freitz85/AppleIISd/Datasheets/AppleII_Timing.png

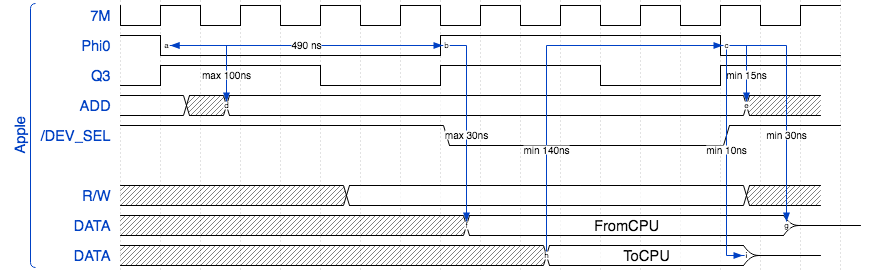
Datasheets/AppleII_Timing.png
