freitz85/AppleIISd/Datasheets/EEPROM_Timing.png

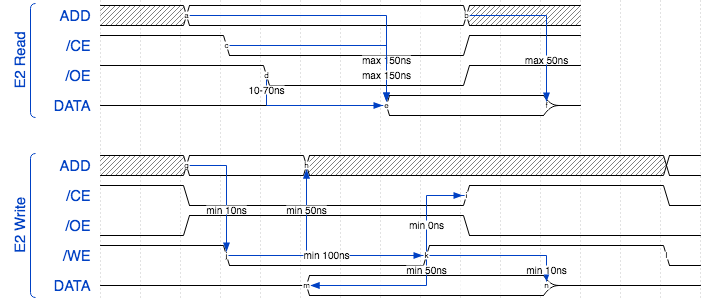
Datasheets/EEPROM_Timing.png
