freitz85/AppleIISd/Datasheets/plcc44_bottom.jpg

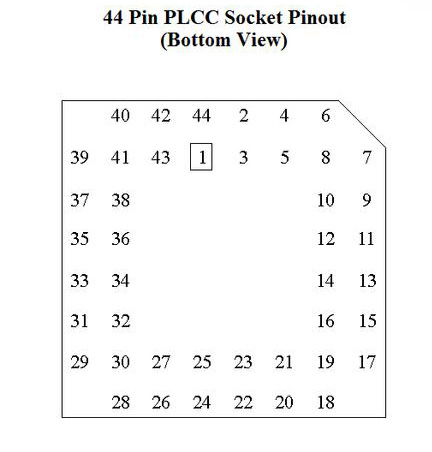
Datasheets/plcc44_bottom.jpg
