freitz85/AppleIISd/Images/Bus1.gif

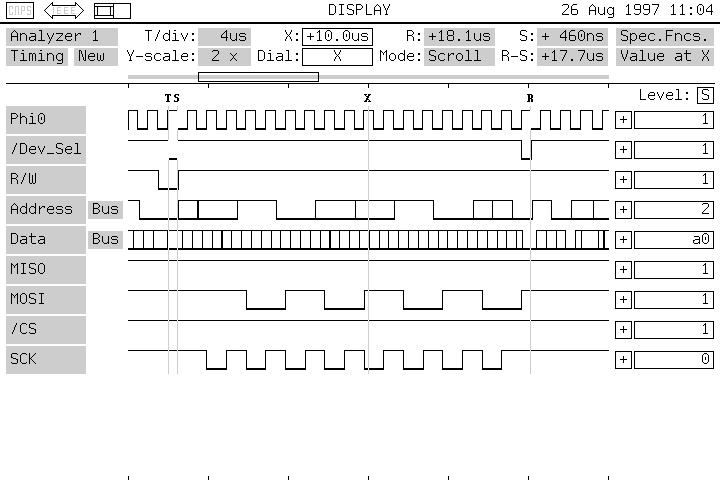
Images/Bus1.gif
