freitz85/AppleIISd/Images/Bus2.gif

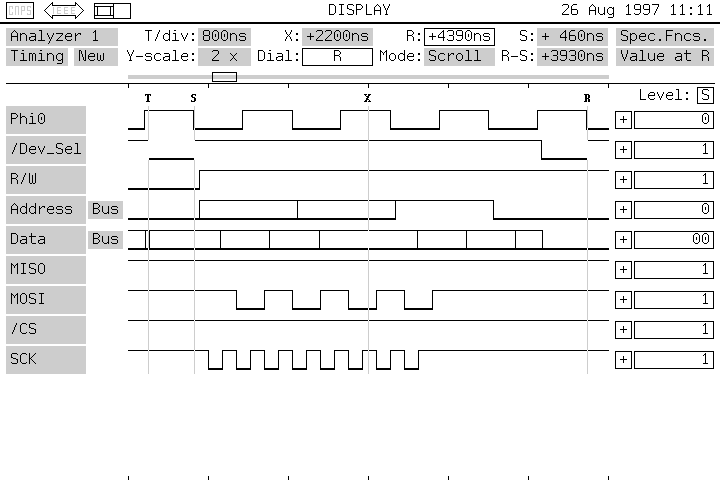
Images/Bus2.gif
