freitz85/AppleIISd/Images/Spi1.png

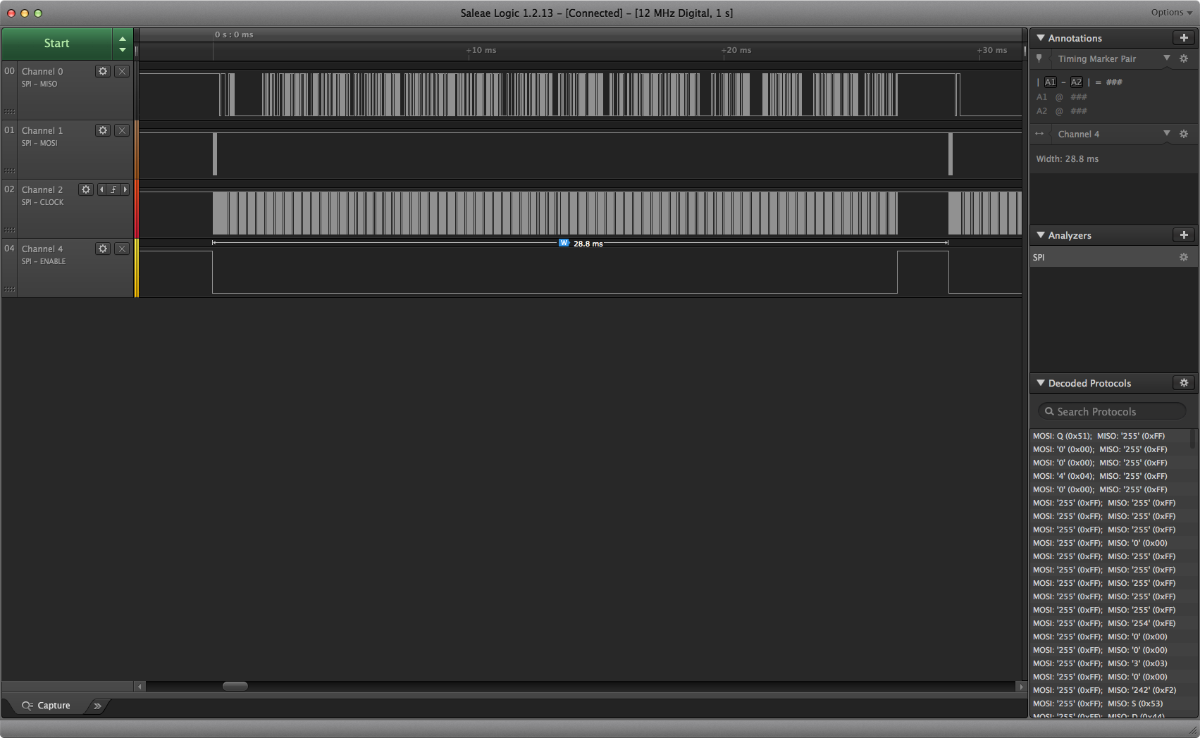
Images/Spi1.png
