freitz85/AppleIISd/Images/Spi2.png

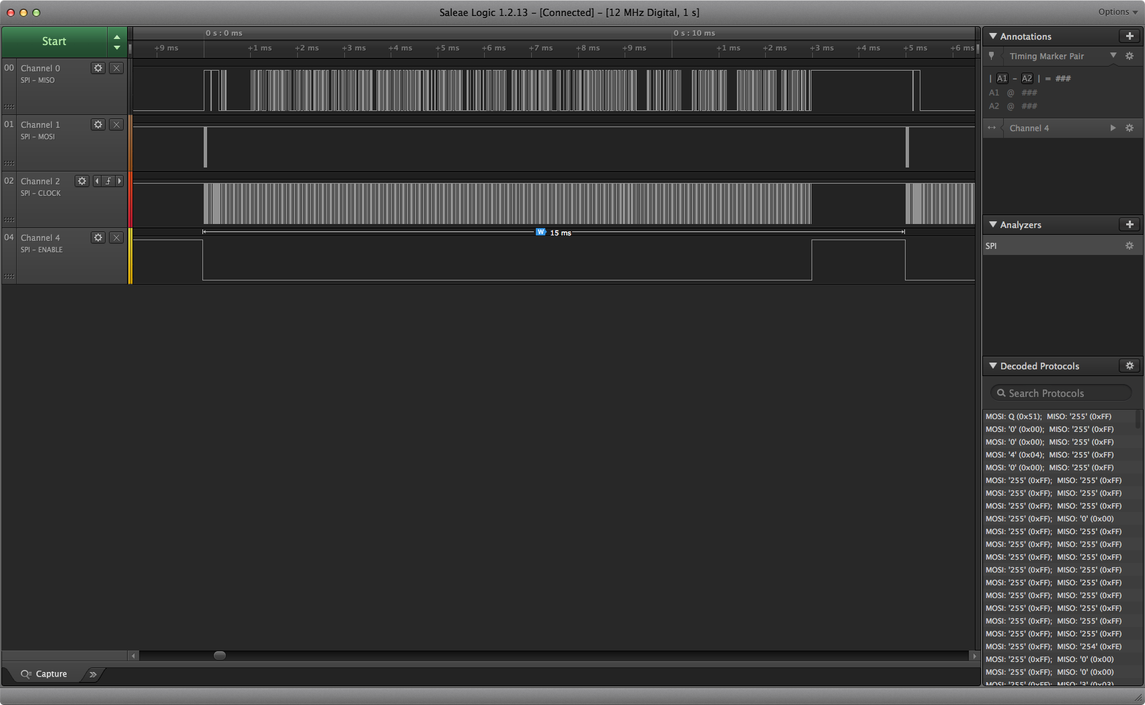
Images/Spi2.png
