freitz85/AppleIISd/Images/AddessDecoder_Test.JPG

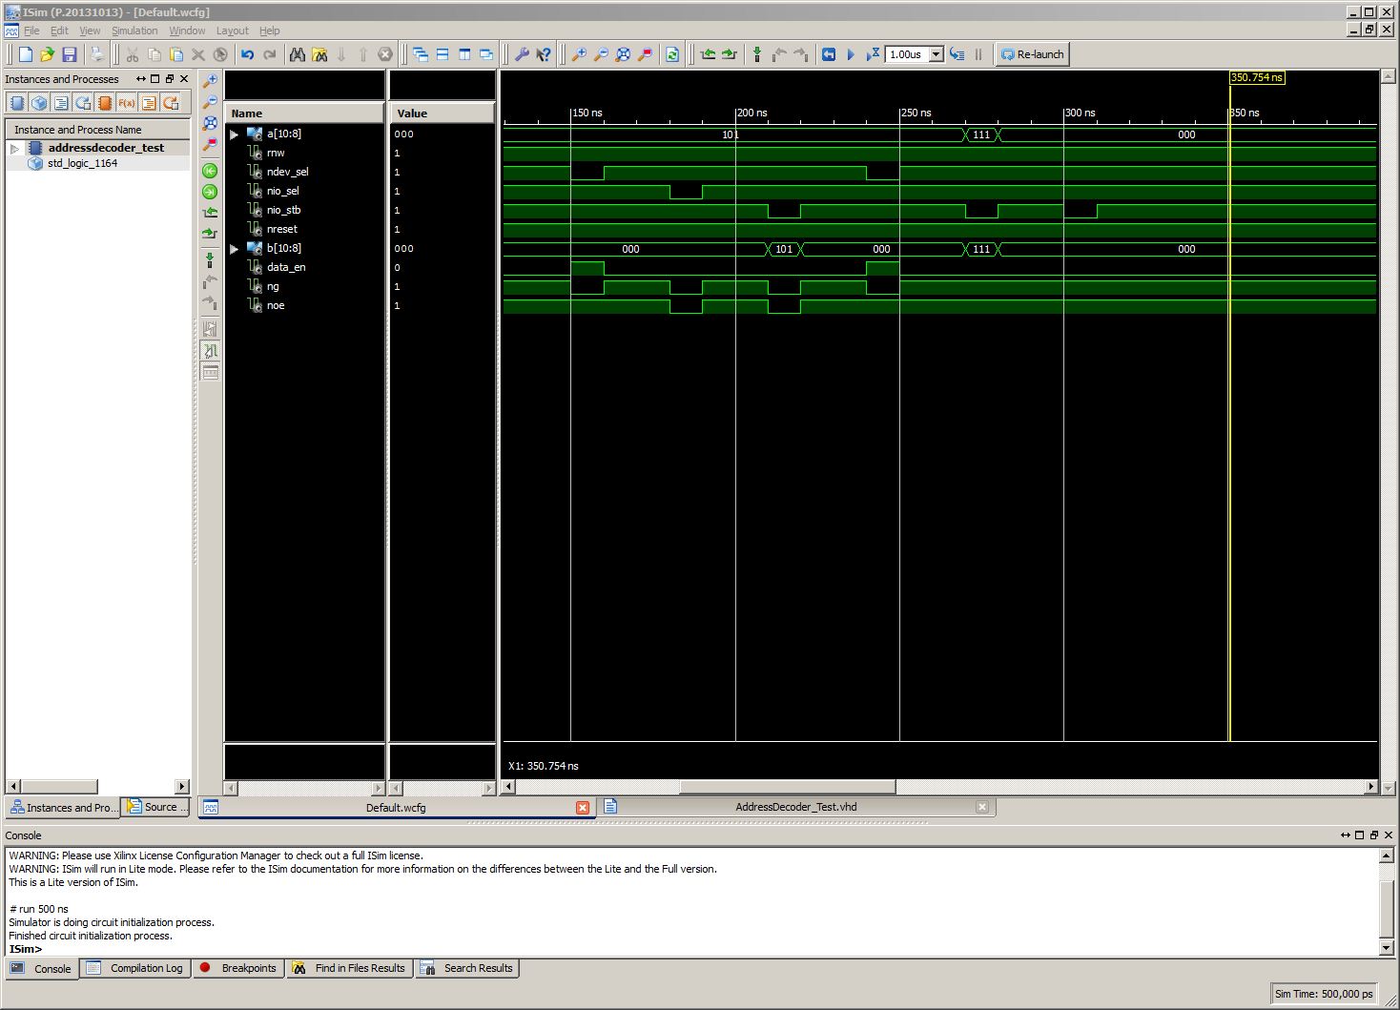
Images/AddessDecoder_Test.JPG
