freitz85/AppleIISd/Images/AppleIISd_Test.JPG

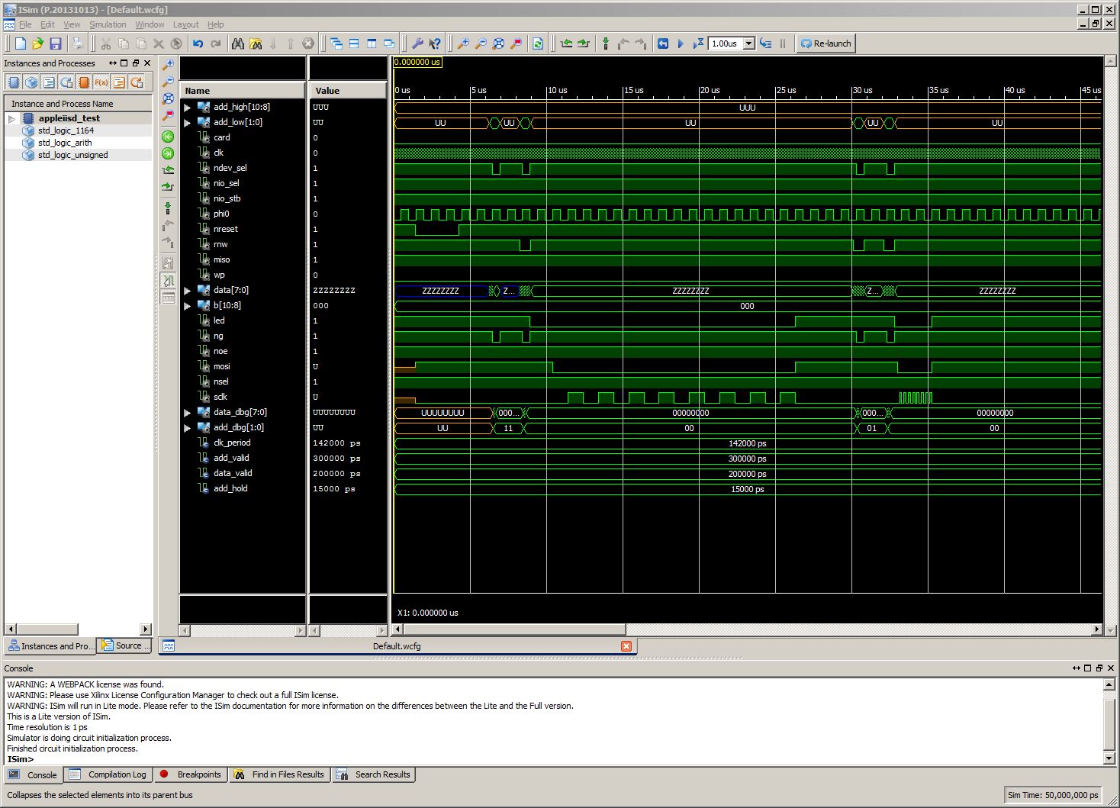
Images/AppleIISd_Test.JPG
