freitz85/AppleIISd/(threads)

Thread 1 (2018-10-10):

Waiting for card ready

vldmrrr, 2018-10-10:
Hello,

I made a card following your design on a prototype board. My card was having multiple problems when with initializing and reading cards so I was never able to boot prodos completely on my ROM 1 gs.

After some debugging I found that data send some time gets garbled by starting new transfer when previous one has not completed yet.

Also conparing with FatFS code for SD SPI I found they are waiting for card to be ready before sending read command.

I added checking of transfer compete on each send, and waiting for card ready for every command (except the very first one on init). Maybe that is an overkill, but at least this made my card able to init both v.1 and v.2 SD cards, and boot and work with prodos more or less reliably. I still can not boot gs/os though.

Take a look at pull request, maybe you would like to merge some or all of the changes into your code.

Thanks

freitz85, 2020-08-12:
Issue is outdated as code has been changed multiple times

Closed 2020-08-12.

Thread 3 (2019-11-27):

Booting no longer works on an Apple IIe

bokowski, 2019-11-27:
Booting the example image from an SD card does not work when using the latest state from the master branch. I ordered PCBs using the current Gerber files, configured the CLPD and burnt an EPROM and couldn't get it to work in my Apple IIe. It did work after I decided to try burning the EPROM image from commit f199354 ("ProDOS image for testing added").
I'm happy now but thought it would be useful to report this problem to you.

freitz85, 2019-11-28:
Thank you for letting me know, I will look into it!
Between those two commits, the Smartport driver was added and since nothing has changed.
Just to make sure, are you using an enhanced IIe with a 65C02 CPU?

bokowski, 2019-11-28:
Yes, I have an enhanced IIe with the 65C02 CPU. By the way, I completely
forgot to thank you for publishing this project, great work!

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

rapiqui, 2020-08-11:
Hi,

I am experiencing the same behavior commented by @bokowski .
I do have an enhanced IIe with a WDC65C02 (W65C02S6TPG-14 with pin 8 and 36 connected as per WDC note) and CD, EF and Video ROMS enhanced.
When I do try to boot a ProDOS image copied to a 2Gb SD with CiderPress I always get prompted to the System Monitor:

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

freitz85, 2020-08-12:
@rapiqui I have just pushed a change in commit 758abfde4b54e888f47e320f820b1ec8bff0dc5f that fixed an issue that the firmware could overwrite itself. Are you able to build the firmware or do you need a binary image?

In the fixes branch, I am still working on problems in the smartport part of the driver. Pure ProDOS mode (2 partitions) seems to work better there.

rapiqui, 2020-08-12:
Hi @freitz85 .
First of all big THANKS for this amazing project ;)

You would make me things easier if you could upload as well the binary image so I could update de EPROM content with the programmer.

If it can be helpful: just to mention that I have tried to boot the SD on the the Apple IIe slots 7,6,2 and 1 with the same results.
Tried your ProFile.2mg image and the latest version of Total Replay (4.0 alpha 2) with the same SysMon address shown.
Tried too partitioning the SD with CiderPress selecting a single ProDisk partition and 4/6 partitions which made no difference at all.

freitz85, 2020-08-19:
@rapiqui On startup, after initializing the SD card, the ProDOS bootloader is loaded from the first two blocks on the card to address $800 and then is called by a jump to $801, so $803 is the second byte after the start of it. When you are in this error, could you please type `800.880` or `801L` and post the output. This should show if the bootsector has been loaded correctly from the card.

Does the AppleIISd work when booted from a floppy, i.e. can you access any files? If yes, the problem might be in a corrupted image.

Have you followed my [posting ](http://bluemeanie-retro.blogspot.com/2017/12/how-to-prepare-sd-cards-for-appleiisd.html) on how to prepare an SD card? Under certain circumstances, Ciderpress may create a partition that is not on the physical start of the card and the AppleIISd can't handle this.

rapiqui, 2020-08-19:
@freitz85 Thanks for checking it out.
Yes, I did follow your post regarding CiderPress usage to create an usable AppleIISD SD Card.
Eventually I even had to switch from a 16Gb SD to an old 2Gb and afterwards to a 8Gb as CiderPress stated that volumes larger than 8 Gb weren't supported.

I have took a picture of the requested memory dump.
Please, let me know if you need additional info.

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

Cheers

rapiqui, 2020-08-24:
Thanks @freitz85 I had my suspects on the tested SD cards format, and re-formatted them again using the "SD Card Formatter" v.5.0.1 from Tuxera, which is the recommended tool by the SD consortium, but had no luck at all. All the 3 SD cards tested (2 Gb non-HC or XC), 8 Gb SDHC and 16 Gb HC behave the same way.
I will keep my fingers crossed and hope you could find out the reason why this could be happening :)

In regards of the serial card, unfortunately I do not have one, but happy to help and try to find why. If I need one in order that I could provide you more useful information I can try to find one.

freitz85, 2021-08-25:
It admittedly took a very long time, but I managed to push some fixes in b13ed9077f54387077b36edc959048bec4b9f689. Please try if this fixed the booting issues as well as the problems with some SD cards.

timmcross, 2022-03-11:
I am also seeing unstable behavior on my enhanced, platinum Apple IIe (2 memory chips).  It seems to run fine on my IIgs but on the IIe, it takes a few reboots before the card will boot properly.  Other times, it breaks to the monitor.  I can get screencaps if you like.  I will also try it on my older enhanced IIe (8 memory chips).

freitz85, 2022-03-15:
I have had the feedback from some users that they had similar issues but the reason seemed to be with the 74LS245. After swapping it worked, specifically on an Apple II+ with the firmware from the 6502 branch. Older LS parts seem to work better than newer ones, for whatever reason.
Unfortunately I am not able to work on the project right now, but what could be done is to compare the VHDL simulation that is already present in the project with a sample of the card working in an actual computer using a logic analyzer. According to Apple's tech pubs, both a HCT and LS should work, but I have had troubles with HCT as well.

timmcross, 2022-03-19:
Ah, yes.  That seemed to be the issue.  I was using a chip labeled as a 74LS245 I got from Amazon and had issues.  I pulled a 74LS245 from another Apple II motherboard and that worked much better.  Perhaps my Amazon 245 is actually a 74HC245.  Thanks!

rittwage, 2022-08-30:
I have the opposite problem. Mine is not stable on a IIGS either...

I have a ROM1 GS with a 4M RAM card (although that part I don't believe matters- I've tried the Apple 1.5M card also) and the card is in Slot 7. When I boot GSOS from the SD card, usually some time late in the load process (not usually always the same place) I will hear a "bonk" (IIgs beep) and it will hang. I can reboot with the keyboard reset, and eventually it will boot fine and run stable, sometimes after a couple of tries. I've replace the SD card and this doesn't seem to matter.

Is there a small issue with the driver, or is it my IIgs?

I can order some other 74LS245 if that is thought to help...

Dirk-, 2022-08-30:
> I have a ROM1 GS with a 4M RAM card (although that part I don't believe matters- I've tried the Apple 1.5M card also) and the card is in Slot 7. When I boot GSOS from the SD card, usually some time late in the load process (not usually always the same place) I will hear a "bonk" (IIgs beep) and it will hang. I can reboot with the keyboard reset, and eventually it will boot fine and run stable, sometimes after a couple of tries. I've replace the SD card and this doesn't seem to matter.

@rittwage Very similar to my problem. I have a ROM03 GS and the card sometimes hangs during boot, sometimes when launching programs. It is not reliable.

My card came fully equipped from Jens Fischer (who handles the "[shop](http://bluemeanie-retro.blogspot.com/2020/04/prebuilt-appleiisd-v121-finally.html)" for @freitz85, I think). I updated the firmware to the latest version, but this didn't help. I wouldn't mind buying another 74LS245 if someone knew a reliable source.

rittwage, 2022-09-23:
 I tried a different brand (and older) 74LS245 as well as a newer 74HCT245. The behavior did not change, unfortunately.

Thread 4 (2021-03-11):

Flash does not work on IIGS ROM1 or ROM3 - always stuck at 4%

chuck424242, 2021-03-11:
I have two AppleIISD cards and wanted to update to 1.2.2 (currently I am on 1.2.1)
I tried the flasher, put the jumper to R/W (2-3). It will start to flash, but always gets stuck at 4%

Tried it on a ROM1 and ROM3 IIGS, in 1MHz and 2.8MHz speeds. Same results on both machines.

freitz85, 2021-03-15:
I have had the same issue on two boards but only on the IIe, the IIgs seemed more reliable.
You could try to erase the EEPROM first by specifying "0" as the slot in the flasher app.

chuck424242, 2021-03-15:
I have tried it, but the erase gets stuck at 1%. I tried again with flashing and it is still the same, stuck at 4%. I guess in the meanwhile I need to unsolder the 28F64 and programm it external. :(

chuck424242, 2021-03-22:
Found something interessting. It is wokring ONLY when a SD Card is inserted. If NO SD Card is in. Flashing will always fail.

freitz85, 2021-03-22:
This is indeed interesting, as the SD card should have no effect at all. The only connection between the part that accesses the SD card and the EEPROM is the write enable bit set in the CPLD registers. Apart from that all address translation for SLOTROM and the $C800 space is completely separate.

chuck424242, 2021-03-23:
Yes, this was surprising to me as well. I did have the SD Cards removed just to be sure there is no interference. I have test a couple of more times, and it is reproduceable, as soon as the SD card is in it always works. As soon as no SD card is in it fails at 1% for erase and 4% for flashing. I have just tested with the 1.2.2. not with 1.2.1 yet

freitz85, 2021-03-23:
Thank you for verifying this behaviour.
I will try to test this and review the VHDL code if some strange interaction has crept in.

If you like to, you could test it with the previous version of the flasher application to see if the behaviour stays the same.

Thread 6 (2022-01-07):

SPI ethernet extension

Sch-LikA, 2022-01-07:
Hello !

I recently came across your amazing project, what an amazing piece of open-source project, thanks for your time ! I will definitively build one when I get my IIgs. As I am also evaluating options to network it, and see that in a way that project is a kind of AppleII-to-spi adapter, would it be possible to implement some ethernet via for example a [WIZ5500 chip](https://www.mouser.ch/datasheet/2/443/Wiznet_W5500_DS_1%200%205-1212109.pdf) ?

Drivers would need to be written for the [Marinetti ip stack](http://www.apple2.org/marinetti/) but that card would become the ultimate card to own !!

Thanks again !

freitz85, 2022-01-10:
Hi,
thank you for your very interesting suggestion! You are right that this is basically an Apple-to-SPI adapter. I will look into the chip to see what is possible with the current design, as there are no I/O pins left on the CPLD.  But I am almost sure we will find a way to make it work.
However, it will take a few weeks as I am currently tied up in other things.

Sch-LikA, 2022-01-10:
Hi ! Thanks for the interest ! I came across a very interesting news : [ESP-WNIC](https://www.youtube.com/watch?v=2E6cgL-LB-I), basically you can use one of those super cheap ESP32 MCU as a Wifi interface (with or without tcp stack), interfaced through spi ... That would be a world premiere, a wifi interface for Apple II :-)

And for the i/o pins, if I understand SPI correctly, only one I/O should be needed, the "chip select" one, that could be either the sd or the ethernet, that could be NOT'ed on the ESP32 (it is a huge MCU in the end). Could one I/O pin be freed somehow (2 would maybe be easier) ?

Since the ESP32 also does Bluetooth, sky's the limit :-) ... keyboard, mouse, gamepad, ...

Thread 7 (2022-01-29):

Post to PCBWay Shared Projects?

dlxmax, 2022-01-29:
I'm glad I found the AppleIISD and your blog as well, as this is exactly what I need for my IIe! Thanks.
One thing, would you mind posting it to PCBWay Shared Projects? That way anyone can order just one board at a very low price. I really don't need ten! It could also help promote the project. More people should know about this.

I would post it myself, but they give a 10% kickback on PCB sales to the poster, which really should be you.
Again, thanks for this. I look forward to building it!
https://www.pcbway.com/project/shareproject/

freitz85, 2022-03-11:
Thank you for this suggestion, I will have a look into it. It sounds very interesting!

Closed 2022-07-11.

Thread 8 (2022-03-01):

Replacement for 28C64

timmcross, 2022-03-01:
Because these are so hard to find, I was thinking of using a 28C256.  I think it has the same pinout just 2 or 3 more address lines which I could pull high or low.

Also, I see the picture uses a -15 part.  Would a -25 part be too slow or is that fine for an IIe or IIgs?

Thanks!

freitz85, 2022-03-04:
Thank you @timmcross, for the suggestion!
I compared the two chips and it should be possible to use both when the the two additional address lines are tied to ground. I will include this in upcoming hardware revisions.
Meanwhile it is possible to use two jumper wire to ground, as the pins were not connected yet.

Regarding the speed I will have to do some more digging, but I assume a slower one could be fine.

timmcross, 2022-03-11:
I was able to ground out the extra address lines (A11 and A12 were already grounded, I added A13, A14 from the 28c256) and it seems to work fine.  I didn't try a -25 part however.  Thanks!

Closed 2022-03-11.

Thread 9 (2022-03-07):

CPLD programming

timmcross, 2022-03-07:
Sorry for an obvious question but after setting this project up from scratch, I think I am missing the part where the CPLD gets programmed.  I am having an issue with the flasher program (using a 28C256 but that is probably a different issue) but I assume that is only to flash the EEPROM?  I have been looking for the overall steps to set one of these up and I cannot find it.  Will flasher upload code to the EEPROM which will in turn flash the CPLD or does the CPLD need to be programmed separately?  Perhaps by a Raspberry PI and the included header on the board?  Thanks...

timmcross, 2022-03-10:
So I took some time to google XC9572XL programming with a Raspberry PI and found a procedure to program one with xc3sprog.  I used a RPI v1 I had sitting around and programmed the VQ44 jed file you have in the repository.  After that, "flasher" completed and I was able to boot the card!  Great work!  Total Replay booted right up.  Thanks for developing this product!

freitz85, 2022-03-11:
Sorry for answering late, I also wanted to suggest the RPi solution as I found the (knockoff-) Xilinx programers not to be very reliable.
I will add this information to the readme so that others can benefit from this. Thank you for bringing this to my attention.

Closed 2022-03-10.

Thread 12 (2023-11-19):

Six partition update?

dlxmax, 2023-11-19:
As ProDOS v2.5 supports 32 drives per slot (https://prodos8.com/releases/prodos-25/), would it be possible to modify the firmware so that we could get six partitions?

BTW, Great project. Thank you! I built two of these for my own use. One is on a partially-enhanced IIe (just 65C02). It doesn't auto-boot, but typing PR#5 adds to the nostalgia.
