freitz85/AppleIISd/Binary/AppleIISd.pdf

## 470⁺³V³

1

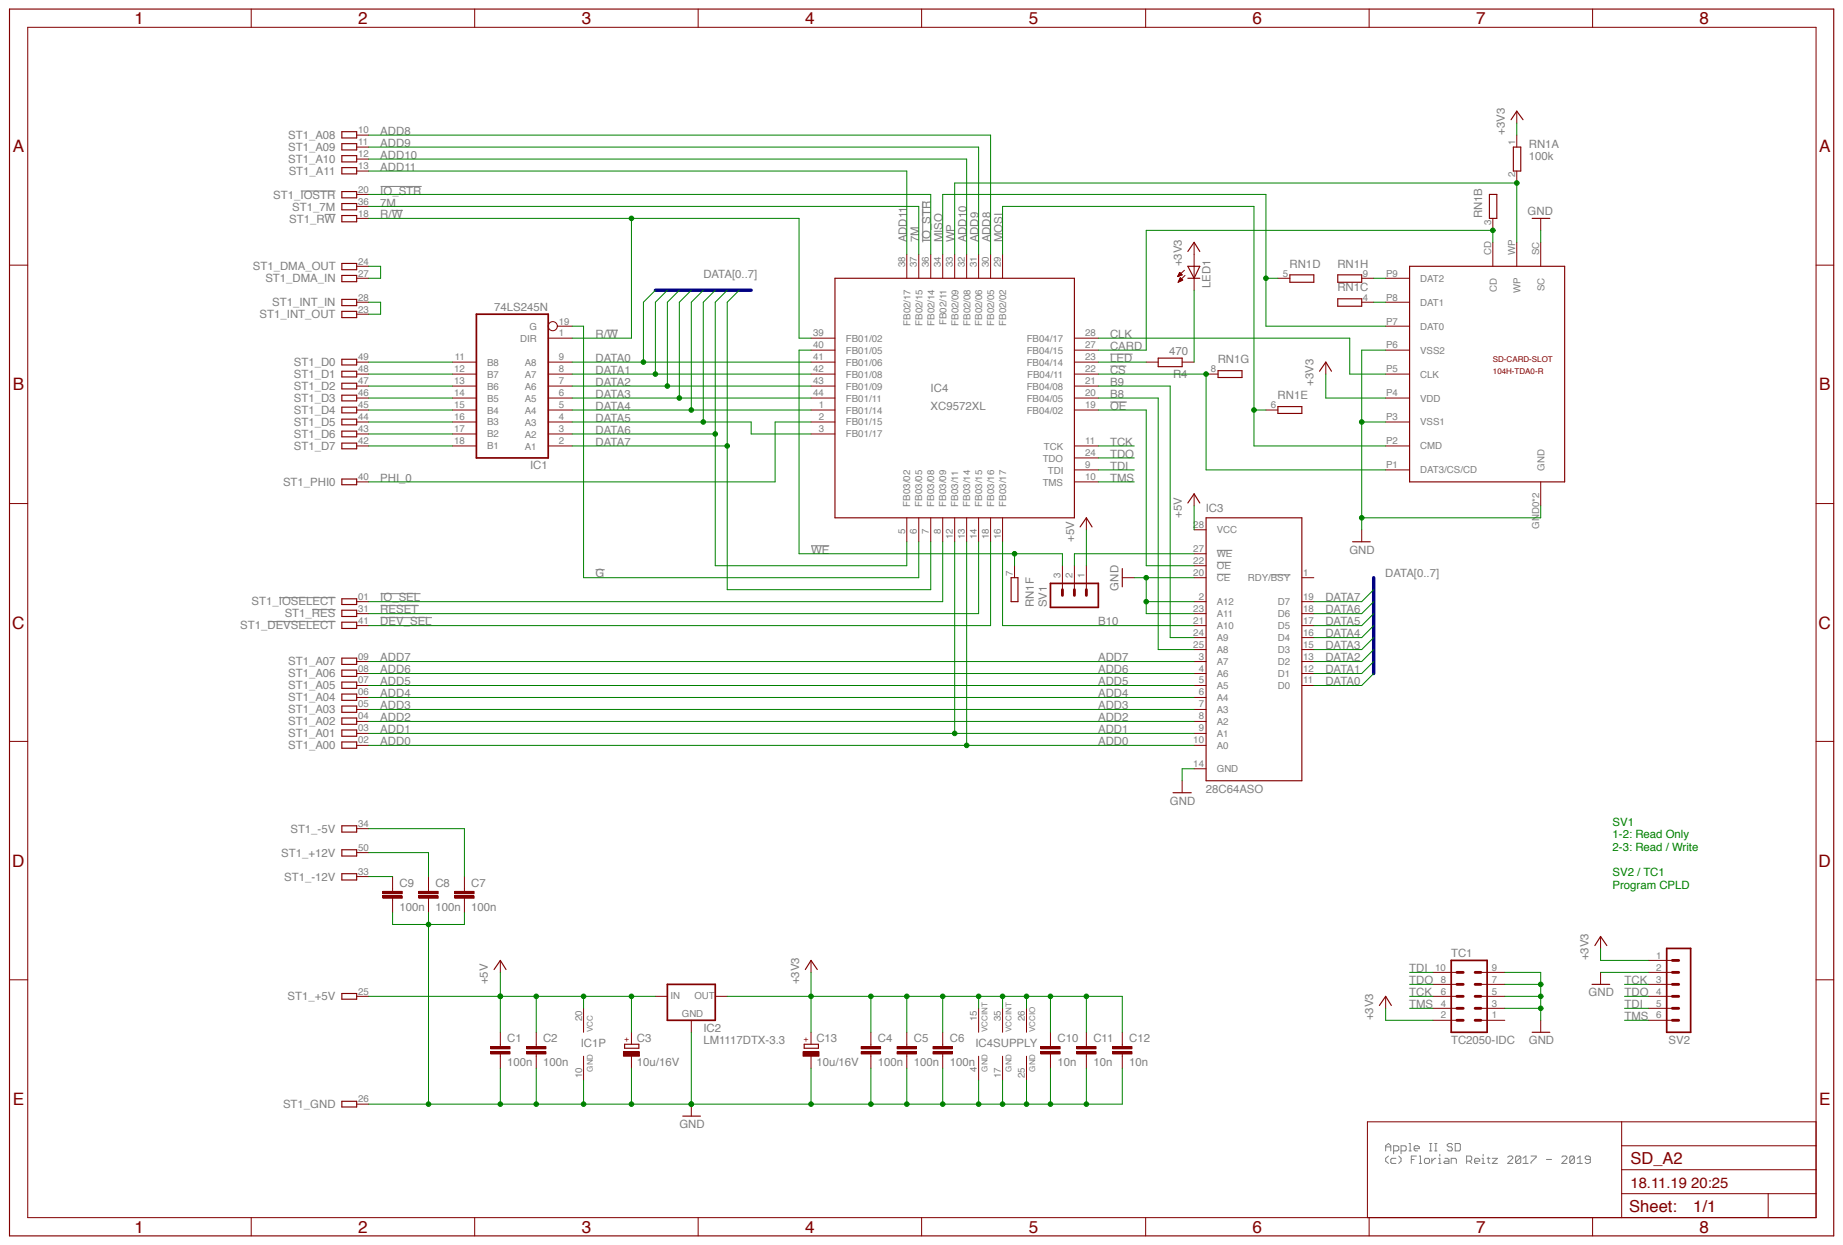
[picture p12: page 1]

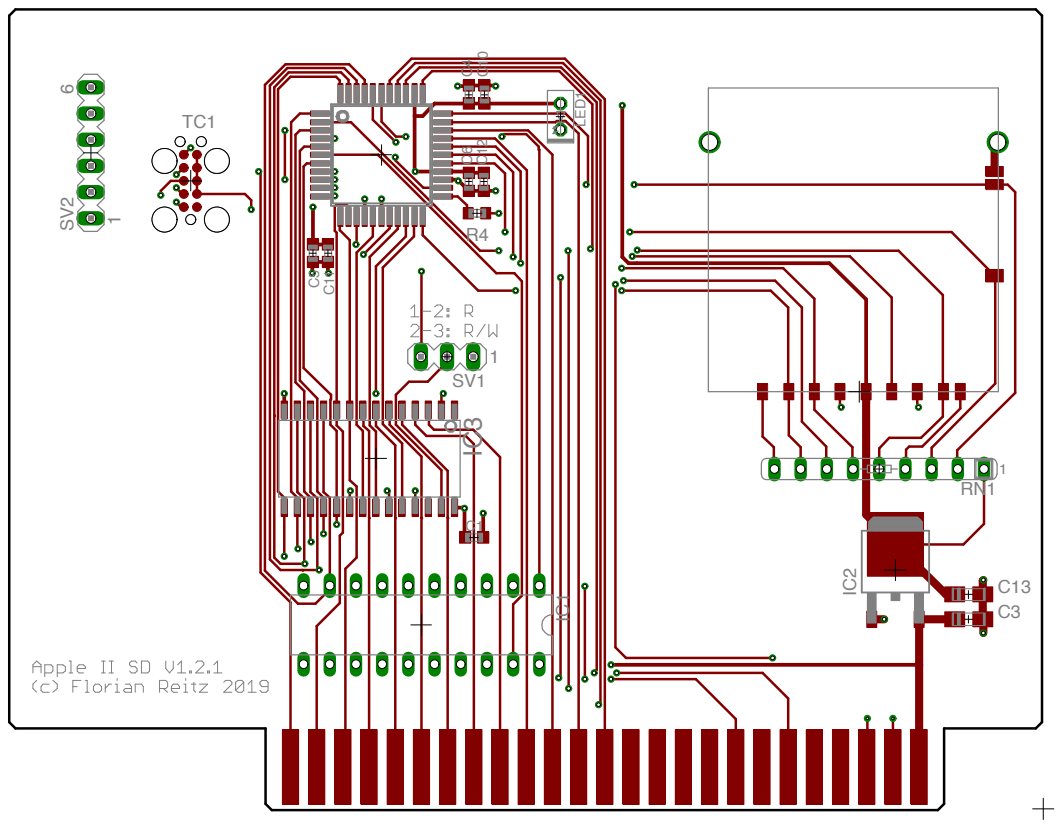
[picture p13: page 2]

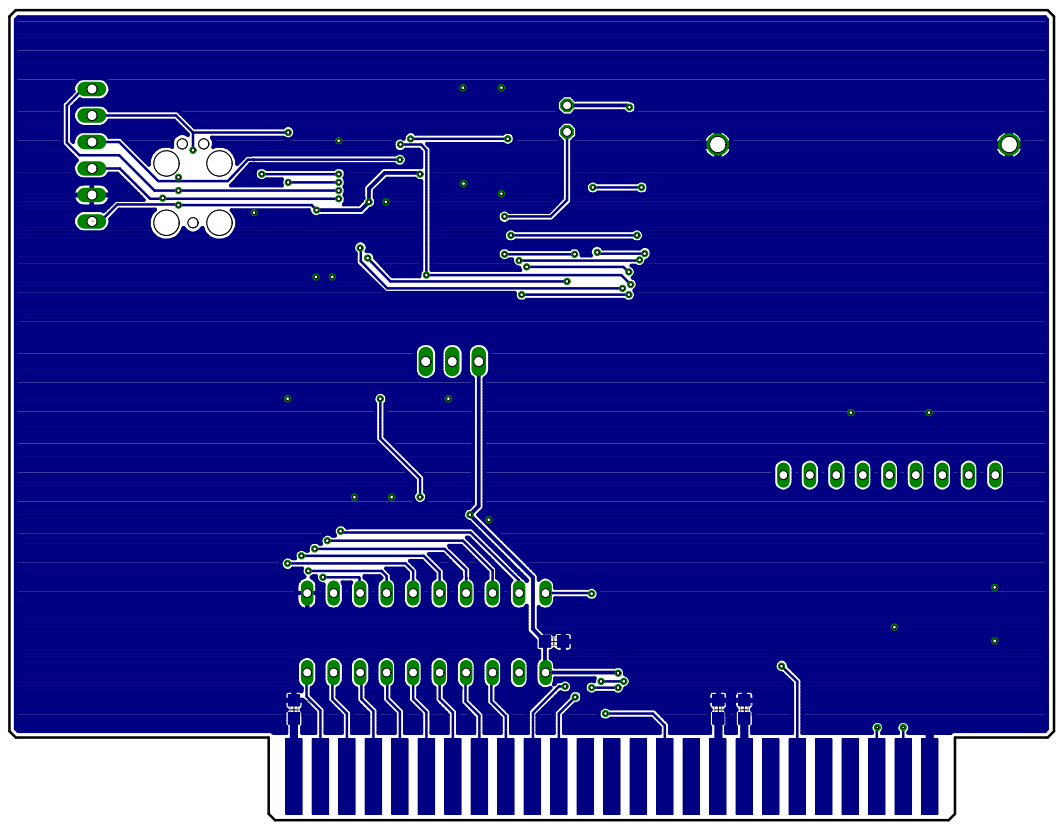
[picture p14: page 3]
