freitz85/AppleIISd/Hardware/SD_A2.brd

## EAGLE design Hardware/SD_A2.brd (2019-11-19)

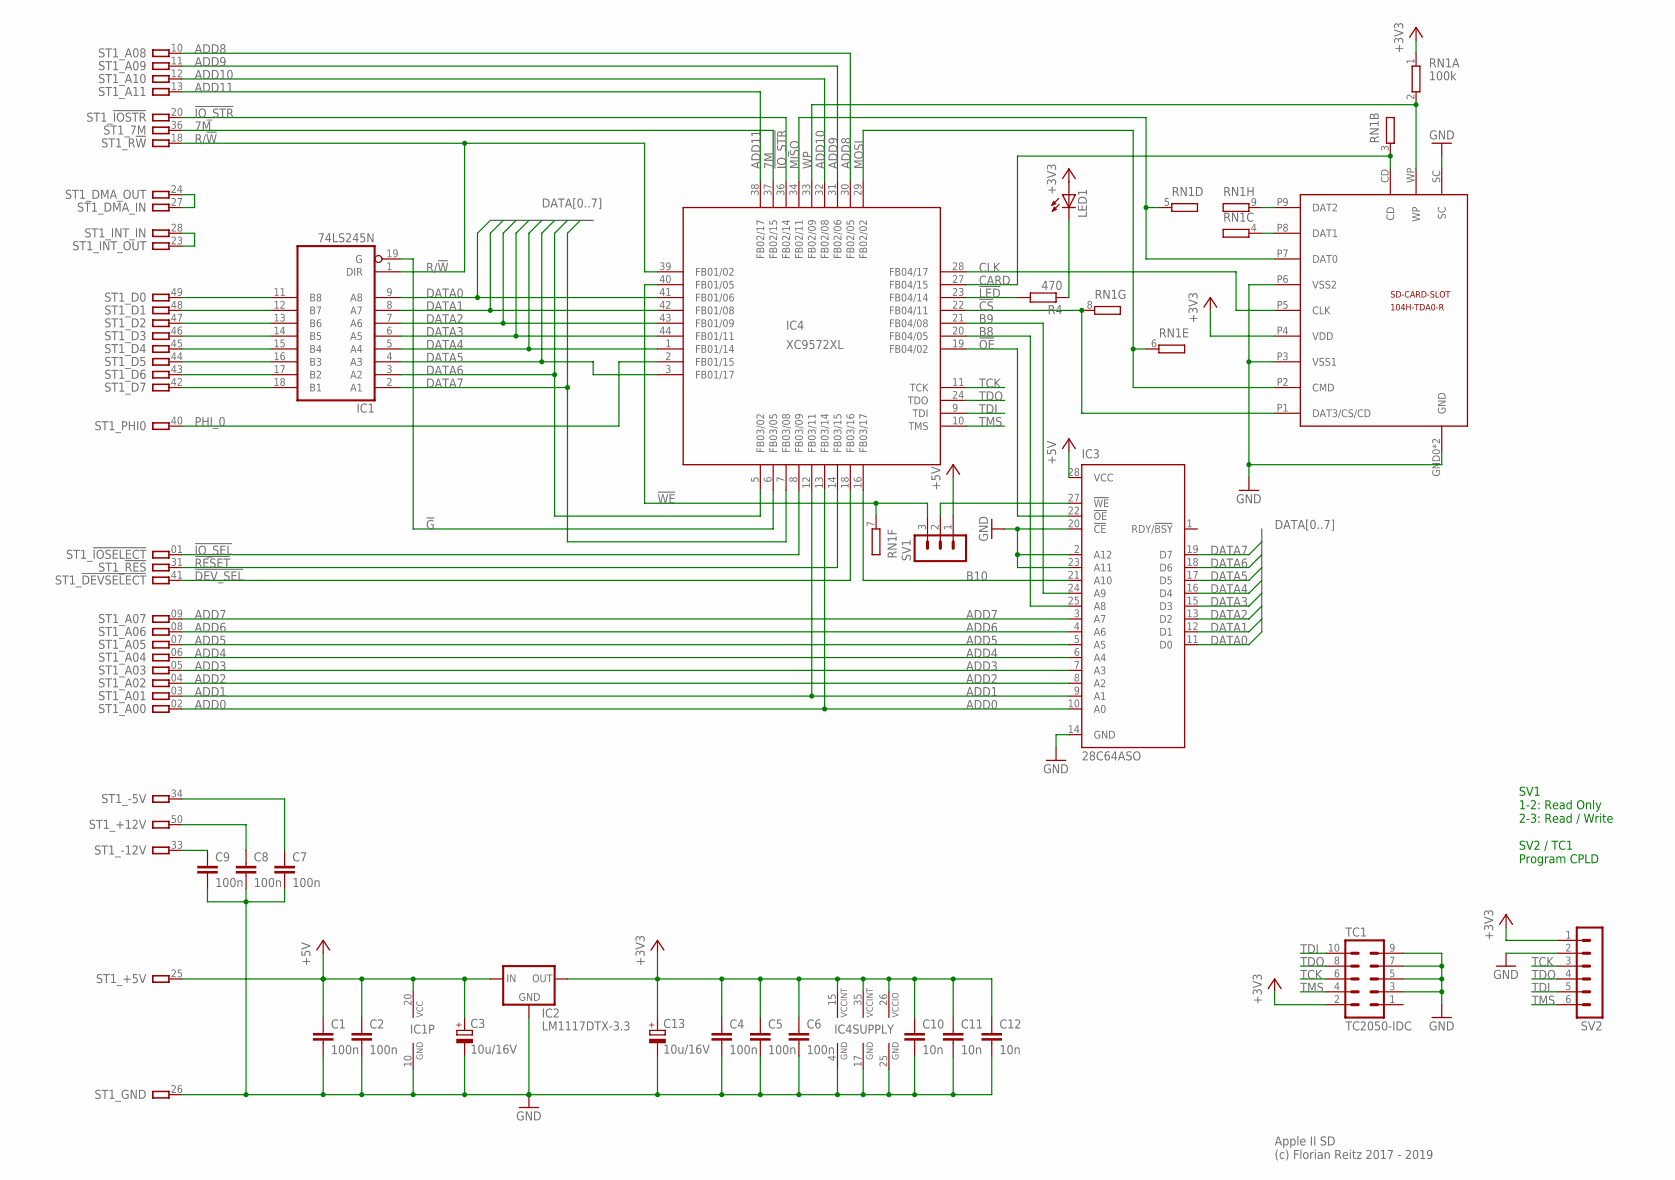
[picture p15: schematic SD_A2.sch]

Parts:
C1, C2, C4, C5, C6, C7, C8, C9: 100n; C0603K
C3, C13: 10u/16V; A/3216-18R
C10, C11, C12: 10n; C0603K
IC1: 74LS245N; DIL20
IC2: LM1117DTX-3.3; TO252
IC3: 28C64ASO; SO28W
IC4: XC9572XL; SQFP-S-10X10-44
LED1: LEDSQR2X5; LED2X5
R4: 470; R0603
RN1: 100k; SIL9
ST1: A2-50PINSLOT1-3; A2-50PIN-SL1-3
SV1: MA03-1
SV2: MA06-1
TC1: TC2050-IDC
U$2: 104H-TDA0-R

Connections:
7M: IC4.37 (FB02/15), ST1.36
!CS: IC4.22 (FB04/11), RN1.8 (2), U$2.P1 (DAT3/CS/CD)
!DEV_SEL: IC4.18 (FB03/16), ST1.41
!G: IC1.19 (G), IC4.6 (FB03/05)
!IO_SEL: IC4.8 (FB03/09), ST1.01
!IO_STR: IC4.36 (FB02/14), ST1.20
!LED: IC4.23 (FB04/14), R4.2
!OE: IC3.22 (!OE), IC4.19 (FB04/02)
!RESET: IC4.14 (FB03/15), ST1.31
!WE: IC4.40 (FB01/05), RN1.7 (2), SV1.3
+3V3: C4.1, C5.1, C6.1, C10.1, C11.1, C12.1, C13.+, IC2.TAB (OUT), IC4.15 (VCCINT), IC4.26 (VCCIO), IC4.35 (VCCINT), LED1.A, RN1.1, SV2.1, TC1.2, U$2.P4 (VDD)
+5V: C1.1, C2.1, C3.+, IC1.20 (VCC), IC2.2 (IN), IC3.28 (VCC), ST1.25, SV1.1
+12V: C8.1, ST1.50
-5V: C7.1, ST1.34
-12V: C9.1, ST1.33
ADD0: IC3.10 (A0), IC4.13 (FB03/14), ST1.02
ADD1: IC3.9 (A1), IC4.12 (FB03/11), ST1.03
ADD2: IC3.8 (A2), ST1.04
ADD3: IC3.7 (A3), ST1.05
ADD4: IC3.6 (A4), ST1.06
ADD5: IC3.5 (A5), ST1.07
ADD6: IC3.4 (A6), ST1.08
ADD7: IC3.3 (A7), ST1.09
ADD8: IC4.30 (FB02/05), ST1.10
ADD9: IC4.31 (FB02/06), ST1.11
ADD10: IC4.32 (FB02/08), ST1.12
ADD11: IC4.38 (FB02/17), ST1.13
B8: IC3.25 (A8), IC4.20 (FB04/05)
B9: IC3.24 (A9), IC4.21 (FB04/08)
B10: IC3.21 (A10), IC4.16 (FB03/17)
CARD: IC4.27 (FB04/15), RN1.3 (2), U$2.CD
CLK: IC4.28 (FB04/17), U$2.P5 (CLK)
D0: IC1.11 (B8), ST1.49
D1: IC1.12 (B7), ST1.48
D2: IC1.13 (B6), ST1.47
D3: IC1.14 (B5), ST1.46
D4: IC1.15 (B4), ST1.45
D5: IC1.16 (B3), ST1.44
D6: IC1.17 (B2), ST1.43
D7: IC1.18 (B1), ST1.42
DAT2: RN1.9 (2), U$2.P9 (DAT2)
DATA0: IC1.9 (A8), IC3.11 (D0), IC4.41 (FB01/06)
DATA1: IC1.8 (A7), IC3.12 (D1), IC4.42 (FB01/08)
DATA2: IC1.7 (A6), IC3.13 (D2), IC4.43 (FB01/09)
DATA3: IC1.6 (A5), IC3.15 (D3), IC4.44 (FB01/11)
DATA4: IC1.5 (A4), IC3.16 (D4), IC4.1 (FB01/14)
DATA5: IC1.4 (A3), IC3.17 (D5), IC4.3 (FB01/17)
DATA6: IC1.3 (A2), IC3.18 (D6), IC4.5 (FB03/02)
DATA7: IC1.2 (A1), IC3.19 (D7), IC4.7 (FB03/08)
DMA: ST1.24, ST1.27
GND: C1.2, C2.2, C3.-, C4.2, C5.2, C6.2, C7.2, C8.2, C9.2, C10.2, C11.2, C12.2, C13.-, IC1.10 (GND), IC2.1 (GND), IC3.2 (A12), IC3.14 (GND), IC3.20 (!CE), IC3.23 (A11), IC4.4 (GND), IC4.17 (GND), IC4.25 (GND), ST1.26, SV2.2, TC1.3, TC1.5, TC1.7, TC1.9, U$2.GND0 (GND), U$2.GND1 (GND), U$2.P3 (VSS1), U$2.P6 (VSS2), U$2.SC
INT: ST1.23, ST1.28
MISO: IC4.34 (FB02/11), RN1.5 (2), U$2.P7 (DAT0)
MOSI: IC4.29 (FB02/02), RN1.6 (2), U$2.P2 (CMD)
unnamed: IC3.27 (!WE), SV1.2
unnamed: RN1.4 (2), U$2.P8 (DAT1)
unnamed: LED1.K (C), R4.1
PHI_0: IC4.2 (FB01/15), ST1.40
R/!W: IC1.1 (DIR), IC4.39 (FB01/02), ST1.18
TCK: IC4.11 (TCK), SV2.3, TC1.6
TDI: IC4.9 (TDI), SV2.5, TC1.10
TDO: IC4.24 (TDO), SV2.4, TC1.8
TMS: IC4.10 (TMS), SV2.6, TC1.4
WP: IC4.33 (FB02/09), RN1.2, U$2.WP

Notes on the sheet:
Apple II SD (c) Florian Reitz 2017 - 2019
SV1 1-2: Read Only 2-3: Read / Write SV2 / TC1 Program CPLD

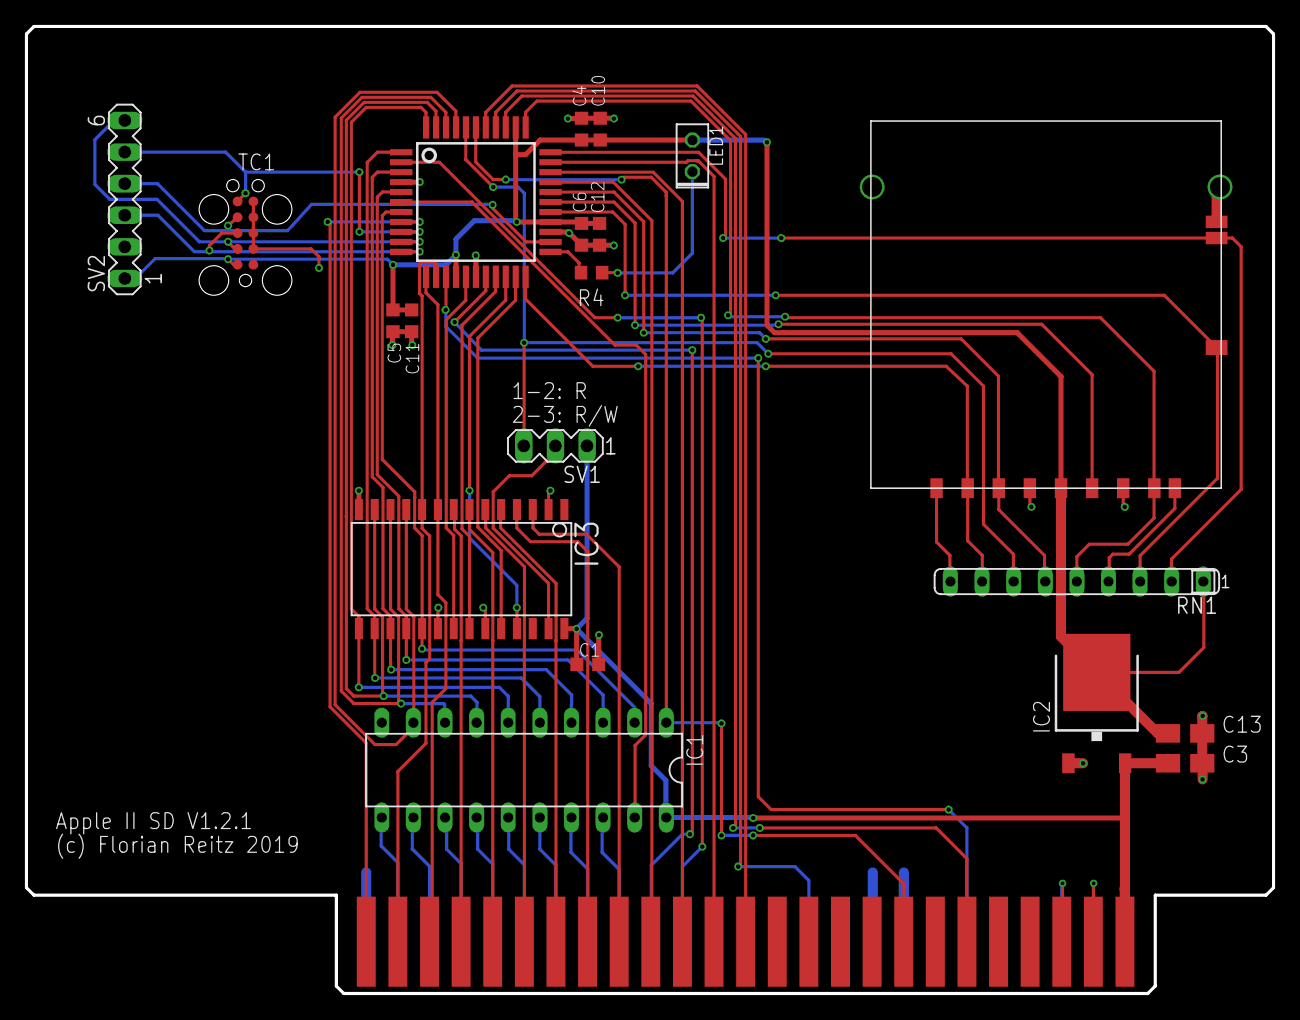
[picture p16: board SD_A2.brd from above]

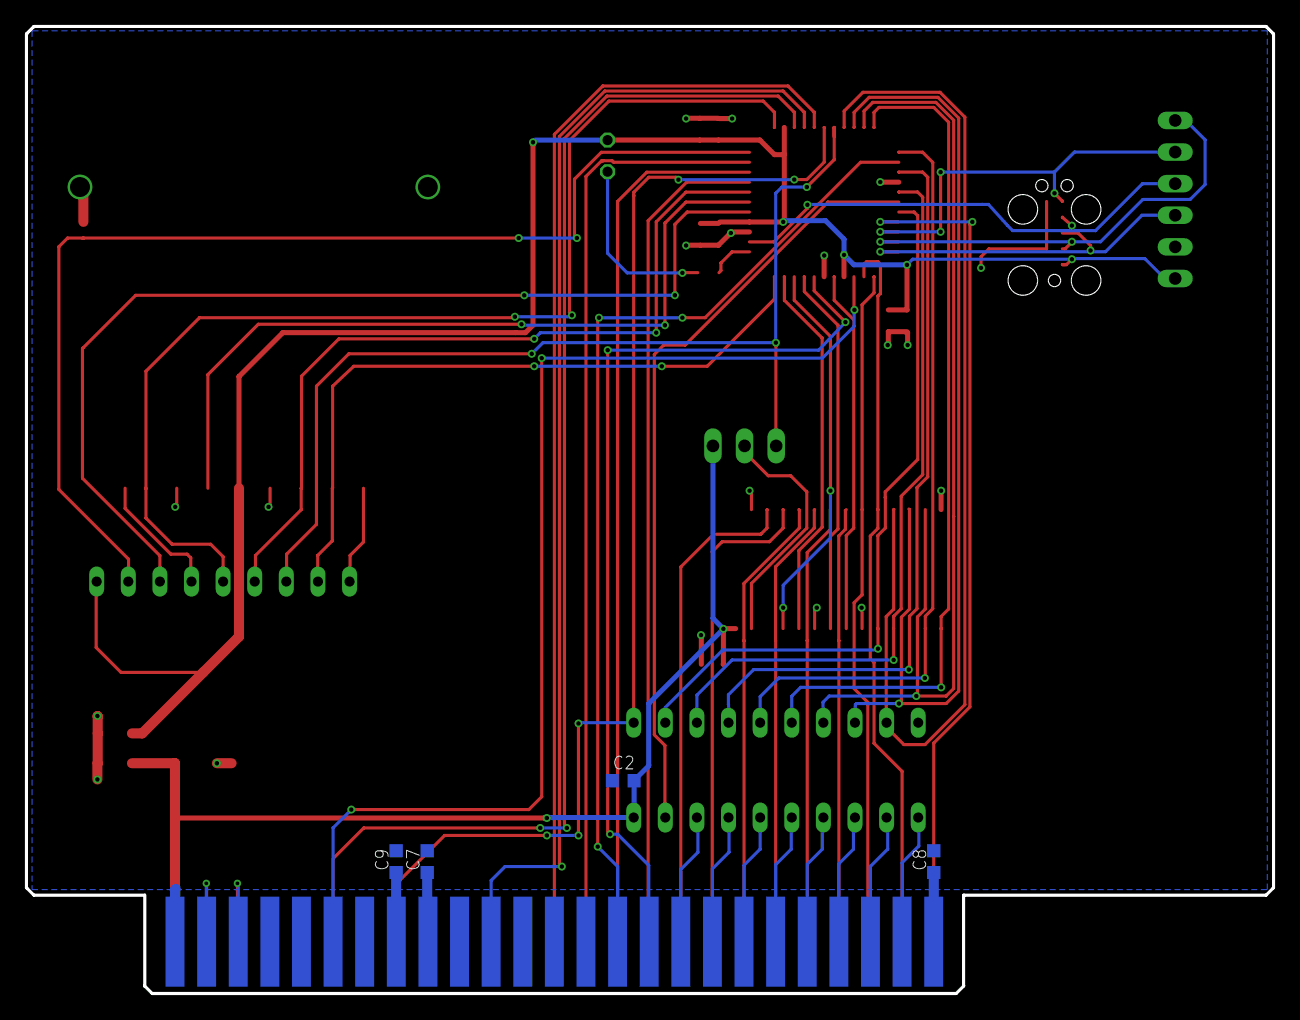
[picture p17: board SD_A2.brd from below]

Board: 2 copper layers, 100.2 x 77.7 mm, 25 parts (4 on the bottom side), 64 nets.
