freitz85/AppleIISd/(commit log)

2017-05-06 files added
    [spi6502b_pad.csv]
2017-05-06 additional misos and int removed
    [spi6502b_pad.csv]
2017-07-05 folder structure added
    [SD_A2.brd, SD_A2.sch, spi6502b_pad.csv]
2017-07-05 address decoder added
    [address_decoder.sch, spi6502b_pad.csv]
2017-07-05 removed unnecessary Xilinx files
    [address_decoder.sch, spi6502b_pad.csv]
2017-07-05 File rename
    [AddressDecoder.sch]
2017-07-05 Address decoding corrected
    [AddressDecoder.sch]
2017-07-05 Pinning changed
    [SD_A2.brd, SD_A2.sch]
2017-07-05 signal rename and pinning
    [AddressDecoder.sch]
2017-07-05 !CE on GND
    [SD_A2.brd, SD_A2.sch]
2017-07-09 Pin changes, libraries added
    [SD_A2.brd, SD_A2.sch]
2017-07-09 Pin changes
2017-07-12 R and C changed to SMD
    [SD_A2.brd, SD_A2.sch]
2017-07-18 - Gerber files
    [SD_A2.brd, SD_A2.sch]
2017-08-11 Small changes on board
    [SD_A2.brd, SD_A2.sch]
2017-08-24 Schematic as PDF and BOM
2017-10-05 PLCC44 Socket Pinout
2017-10-05 several fixes tried
    [AddressDecoder.sch]
2017-10-08 test with clocked input buffers
    [AddressDecoder.sch, in_buf.sch, io_buffers.sch]
2017-10-10 Test bench worst and best case timings
2017-10-10 AddressDecoder in VHDL
    [AddressDecoder.sch]
2017-10-10 Rename files
    [in_buf.sch, io_buffers.sch]
2017-10-10 Spi simulation working
2017-10-16 IRQ Pin removed, A11 added
    [SD_A2.brd, SD_A2.sch]
2017-10-16 Test for old AddressDecoder
    [AddressDecoder_old.sch]
2017-11-01 SPI Mode 3
2017-11-25 VS2015 project added
    [appleiisd.cfg]
2017-11-30 Schematic updated
    [SD_A2.brd, SD_A2.sch]
2017-11-30 Change in makefile and folder structure
    [AppleIISd.cfg]
2017-12-01 Schematic PDF updated
    [SD_A2.brd, SD_A2.sch]
2017-12-05 Gerber for V1.1
2017-12-19 Test with phantom slots
2018-05-17 ProDOS jump table moved
    [AppleIISd.cfg]
2018-05-22 Prepared for Smartport
    [AppleIISd.cfg]
2019-03-03 NWE added to schematic and layout
    [SD_A2.brd, SD_A2.sch]
2019-03-03 LED removed from AddressDecoder
2019-03-03 Tag Connect added
    [SD_A2.brd, SD_A2.sch]
2019-03-03 EEPROM as SMD
    [SD_A2.brd, SD_A2.sch]
2019-03-03 Resistor network added
    [SD_A2.brd, SD_A2.sch]
2019-03-03 Trace width 0.254
    [SD_A2.brd, SD_A2.sch]
2019-03-03 Keepout for Tag Connect
    [SD_A2.brd, SD_A2.sch]
2019-03-03 Rename in AII connector
    [SD_A2.brd, SD_A2.sch]
2019-03-03 Firmware folder added
    [AppleIISd.cfg]
2019-03-03 Flasher project added
    [AddressDecoder_old.sch]
2019-03-07 Flasher working
    [apple2enh-system.cfg]
2019-03-09 Schematic as Eagle V7 file
    [SD_A2.sch]
2019-03-10 BOM and schematic as PDF
2019-03-16 XC9572XL library with VQFP44 package added
    [SD_A2.brd, SD_A2.sch]
2019-03-17 CPLD changed to VQFP package
    [SD_A2.brd, SD_A2.sch]
2019-03-21 LM317 replaced with LM1117
    [SD_A2.brd, SD_A2.sch]
2019-04-10 Gerber for V1.2
    [SD_A2.brd]
2019-06-04 Pullup on /WE added
    [SD_A2.brd, SD_A2.sch]
2019-06-04 Longer slot pins
    [SD_A2.brd, SD_A2.sch]
2019-11-19 R/W jumper re-added
    [SD_A2.brd, SD_A2.sch]
2019-11-22 Gerber V1.2.1
2020-02-09 SMD board image added
